RustyZipTie/gyre-source/md/main.md

gyre demo
<h1>
    - Organization with a twist
</h1>  
<h2>The ultimate 3d-printed organization system for your shop, kitchen, room, house, and more</h2>
<ul id="list1">
    <li>Modular and infinitely expandable</li>
    <li>Free to use and remix</li>
    <li>Customizable</li>
    <li>Unique twist-lock system</li>
    <li>Integrates with Gridfinity</li>
</ul>
<h2>About Gyre</h2>
<p>
    I created Gyre because I like to look at my walls.
    Silly, I know, but I really don't like pegboard-style systems that cover large amounts of surface area.
    They just seem, well, inelegant. <br />
    I set out to design a system that only takes up wall space where it's needed, and leaves the rest open.
    Along the way, I discovered other perks, like the unique aesthetic and the super-satisfying 'click' that the
    parts make when they snap into place. <br/> Being relatively new to CAD modeling, the <a href="./design.md">design process</a> was a wonderful
    learning experience and a ton of fun. I look foreword to building up the catalog of attachments and seeing what
    you all add to it as well. I hope you enjoy Gyre as much as I do. <br/><br />
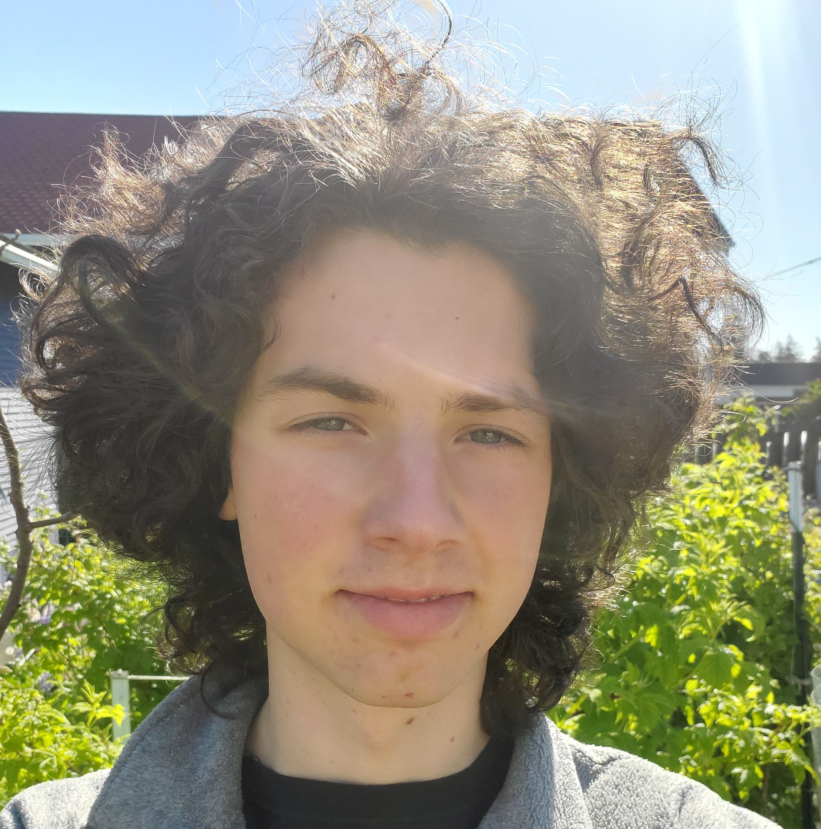
[picture p35: img/pretty/20240420_093342.jpg]
     <br />
    -Kai
</p>
<h2>Get Started</h2>
<ul>
    <li>
        <a href="https://www.thingiverse.com/thing:6913421">Thingiverse</a>-
        Check out the thingiverse page to download models and post comments, makes, and remixes.
    </li>
    <li>
        <a
            href="https://cad.onshape.com/documents/9e06891469d51d2e78eeebf4/w/8d63af5475c88c87d3523b0d/e/9ed6bb0fb271472b238fb4d0">Onshape</a>-
        Check out the original designs (many are configurable!), export in your preferred file format, and create
        your own customizations.
        The sky is the limit!
    </li>
    <li>
        Also check out the <a href="./manual.md">manual</a> for instructions. Remixing guide coming soon.
    </li>
</ul>
