RustyZipTie/gyre-source/step/locks/lock_subtraction_clocking.step

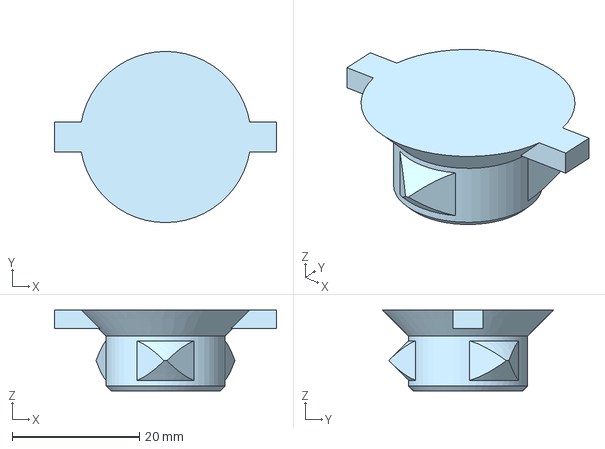
[picture p36: CAD file, 2025-04-08]
step/locks/lock_subtraction_clocking.step
34.9 x 26.9 x 12.7 mm
