RustyZipTie/gyre-source/stl/example/small_parts_bin.stl

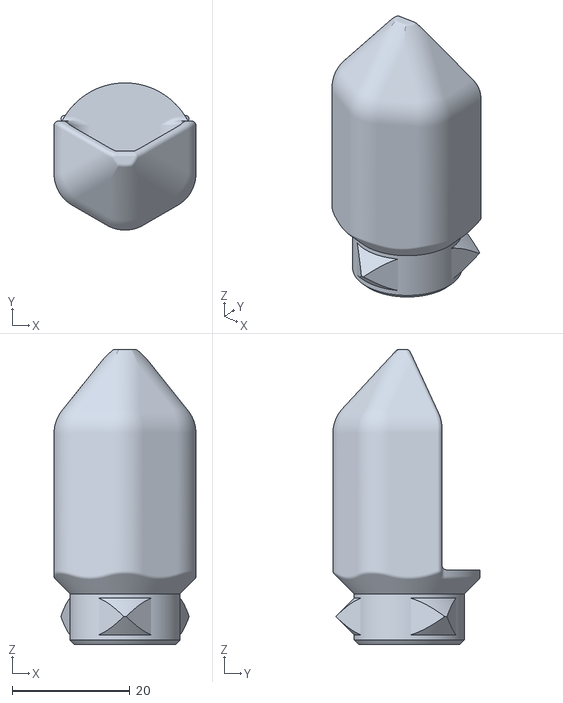
[picture p37: CAD file, 2025-04-08]
stl/example/small_parts_bin.stl
24.1 x 25.0 x 50.2
