RustyZipTie/gyre-source/step/locks/lock_clocking_hollow.step

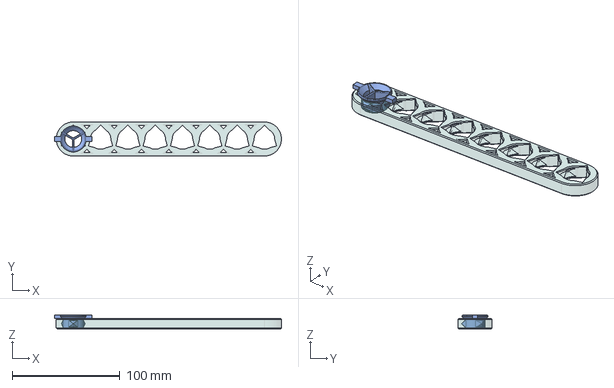
[picture p38: CAD file, 2025-04-08]
step/locks/lock_clocking_hollow.step
211.1 x 31.8 x 12.7 mm
