RustyZipTie/gyre-source/step/locks/lock_basic.step

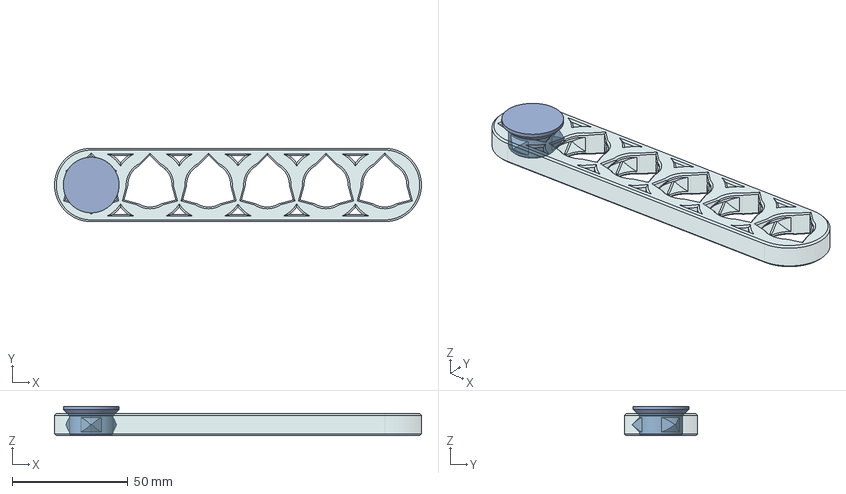
[picture p39: CAD file, 2025-04-08]
step/locks/lock_basic.step
158.8 x 31.8 x 12.7 mm
