RustyZipTie/gyre-source/step/locks/lock_mounting.step

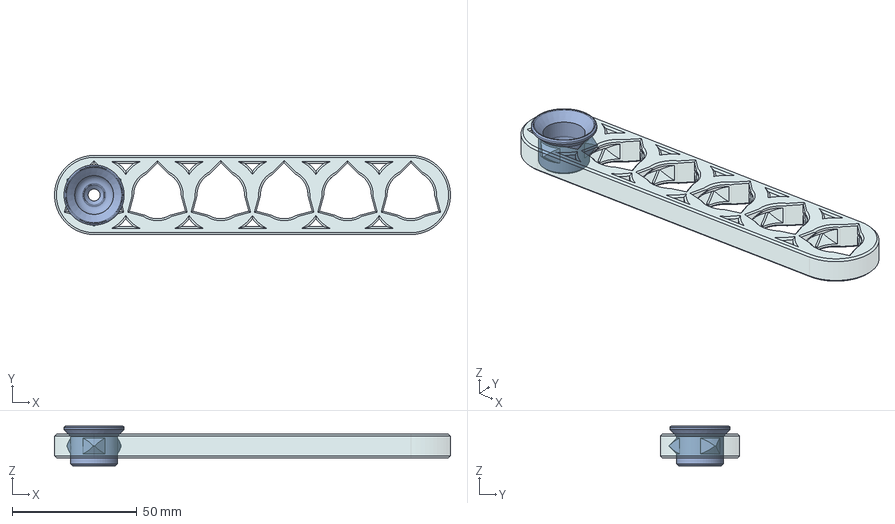
[picture p40: CAD file, 2025-04-08]
step/locks/lock_mounting.step
158.8 x 31.8 x 15.9 mm
