RustyZipTie/gyre-source/(list of files, cad)

Other CAD files:
step/locks/lock_subtraction.step
step/locks/lock_hollow.step
